MofidPolette/Hovercraft/README.md

# Hydroglisseur
Notre projet consiste en un hydroglisseur doté d'une hélice, qui glissera sur l'eau dans la direction voulue grâce à une télécommande bluetooth et qui pourra s'arrêter à un endroit voulu afin de faire descendre une sonde jusqu'à 50 centimètres de profondeur afin de relever la température de l'eau selon la profondeur.
