MofidPolette/Hovercraft/Rapport Final/README.md

Le powerpoint du projet étant trop lourd pour GitHub, ce dernier a été exporté en mp4 et publié sur Youtube.
