MofidPolette/Hovercraft/Rapports/README.md

Les vidéos utilisées dans les rapports sont disponibles en téléchargement (dans le dossier Annexes) 
ou sur notre chaîne Youtube en insérant l'URL présent dans chaque rapport ou dans le fichier Liens 
si les liens ne sont pas accessibles dans les rapports.
