MofidPolette/Hovercraft/Rapports/Liens.md

Annexe 1 ; https://youtu.be/A37Q5lRGnDI

Annexe 2 ; https://youtu.be/bz5ghWsNAQw

Annexe 3 ; https://youtu.be/USGgpJiQXoo

Annexe 4 ; https://youtu.be/VPRgdAAVYVI

Annexe 5 ; https://youtu.be/gVehf0gLDuw

Pignon ; https://youtu.be/8QPDgNjMvSI

Découpe du pignon ; https://youtu.be/KOdOfdhXKKc

Découpe de la crémaillère ; https://youtu.be/jwDR_V_TfrE

Servo-BlueT ; https://youtu.be/dNDl7t-wkcQ

Boite ; https://youtu.be/01u3eDXAoCc

Gouvernail ; https://youtu.be/Z1aPbFnRd7w

Crémaillère ; https://youtu.be/dZPBzIAOk_8

Servomoteur ; https://youtu.be/s0gHOtoGXEI

Brushless ; https://youtu.be/fQYtmKaNbdo

Test Hydroglisseur ; https://youtu.be/Aa5Hlb70eHY

Amélioration gouvernail ; https://youtu.be/KcasSY0N2hw

Amélioration moteur pp ; https://youtu.be/WnuH5ROWdiE

Amélioration planches gouvernail ; https://youtu.be/_2UBe6BtGgo

Test Hydroglisseur avec RF ; https://youtu.be/Z19tR3KAb0E
