MofidPolette/Hovercraft/(commit log)

2018-12-18 Create Brushless+ESC
2018-12-18 Create Servomoteur
2019-02-12 Update and rename Brushless+ESC.ino to Brushless+ESC-BlueT.ino
2019-03-09 Update and rename Brushless+ESC-BlueT.ino to Brushless.ino
2019-03-09 Update and rename Test.md to Brush+Servo.ino
